chakkums/smart-solar/Report & Schematics/Pictures/2013-03-19 19.55.42.jpg

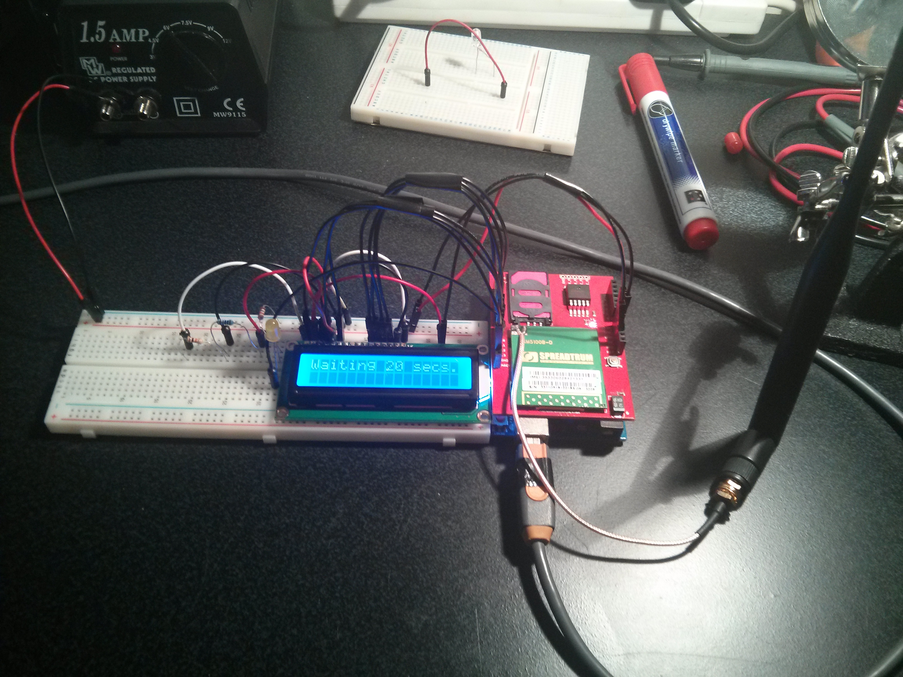
Report & Schematics/Pictures/2013-03-19 19.55.42.jpg
