chakkums/smart-solar/Report & Schematics/Pictures/2013-03-19 19.56.19.jpg

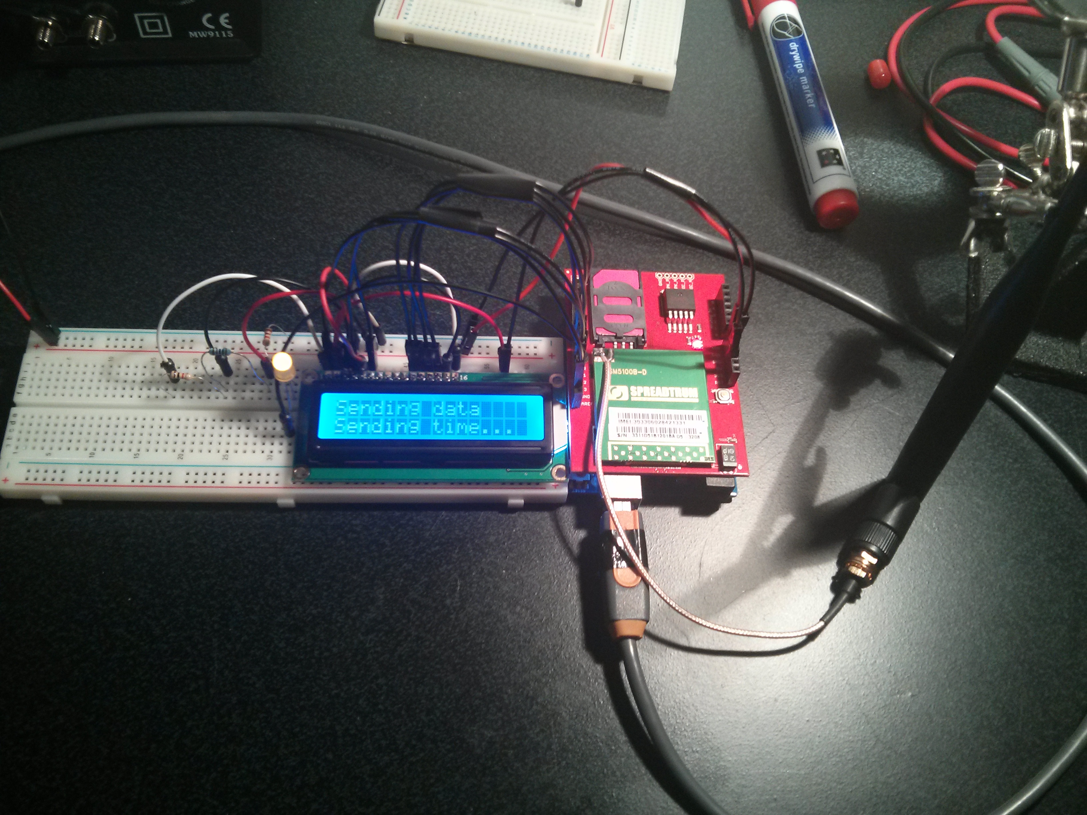
Report & Schematics/Pictures/2013-03-19 19.56.19.jpg
