chakkums/smart-solar/Report & Schematics/Pictures/2013-03-19 19.56.22.jpg

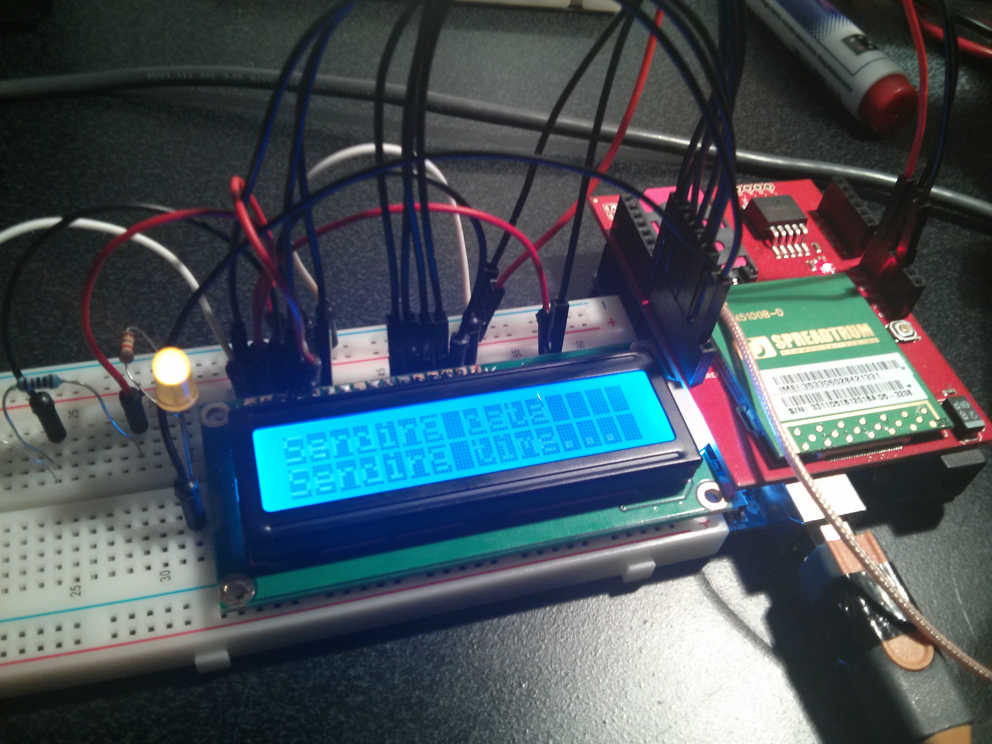
Report & Schematics/Pictures/2013-03-19 19.56.22.jpg
