chakkums/smart-solar/Report & Schematics/Pictures/2013-03-19 19.57.33.jpg

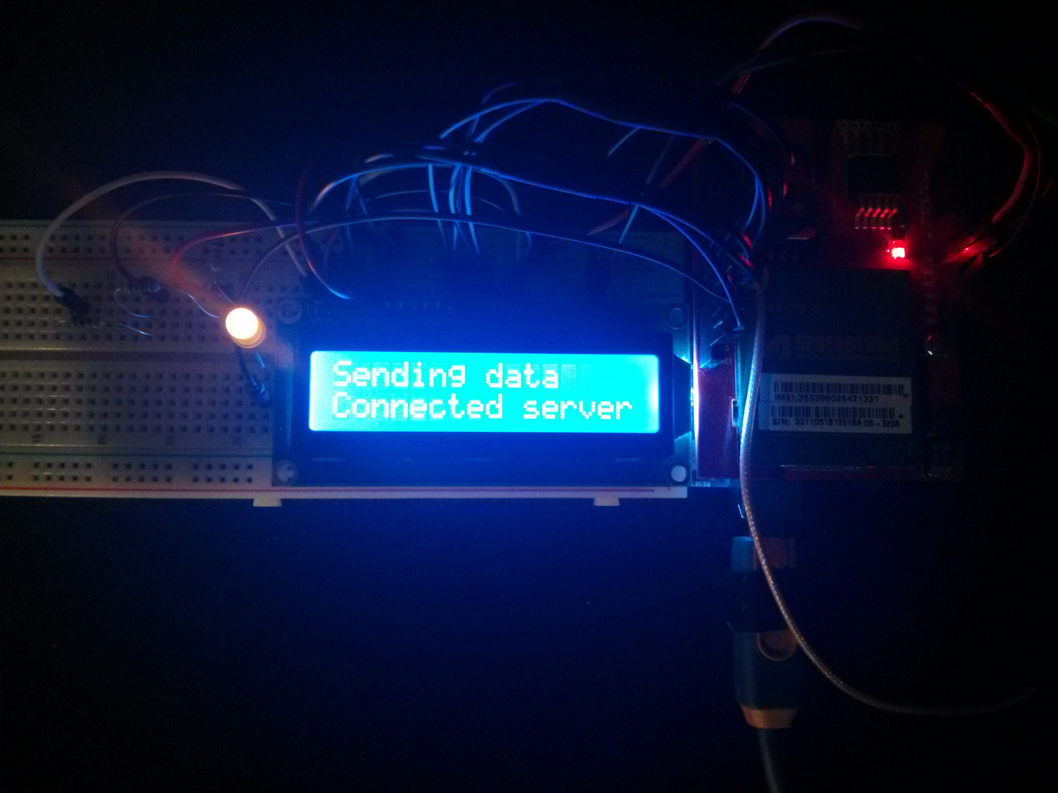
Report & Schematics/Pictures/2013-03-19 19.57.33.jpg
