chakkums/smart-solar/Report & Schematics/Pictures/2013-03-19 19.57.35.jpg

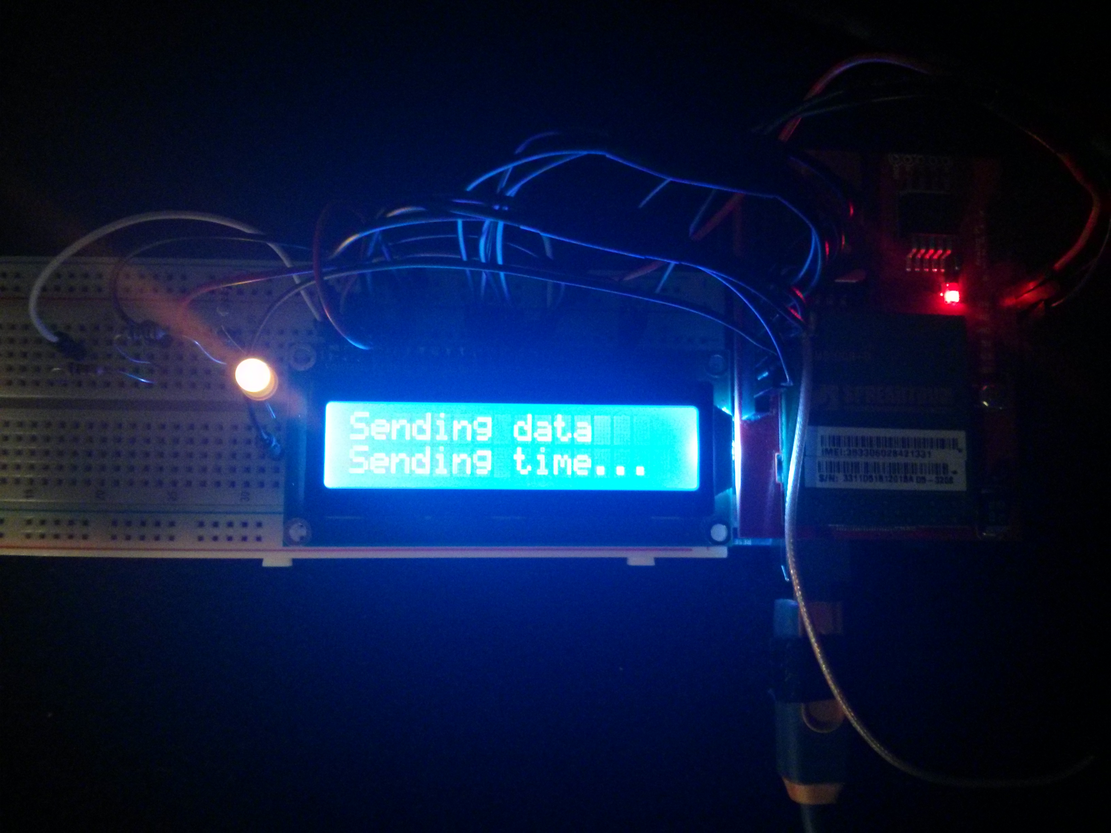
Report & Schematics/Pictures/2013-03-19 19.57.35.jpg
