chakkums/smart-solar/Report & Schematics/Pictures/2013-03-19 19.58.29.jpg

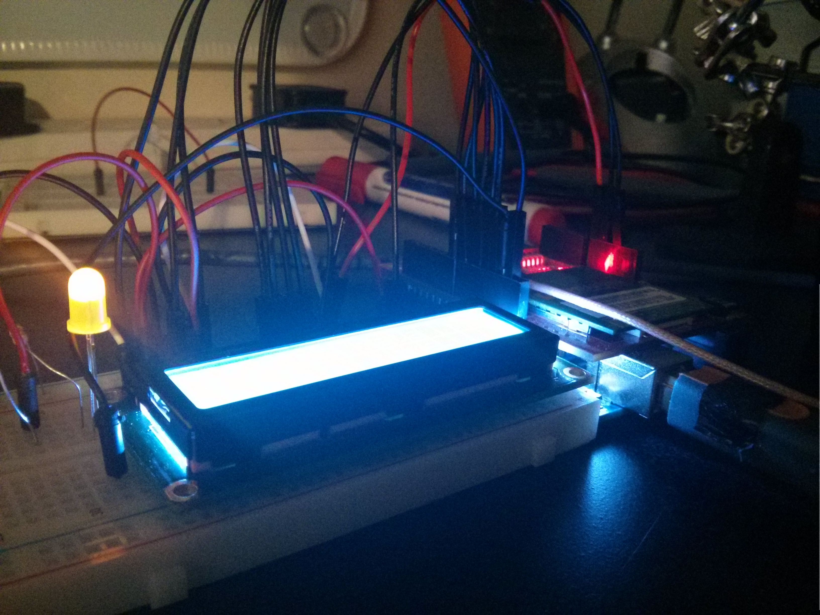
Report & Schematics/Pictures/2013-03-19 19.58.29.jpg
