chakkums/smart-solar/Report & Schematics/Pictures/2013-04-06 00.31.32.jpg

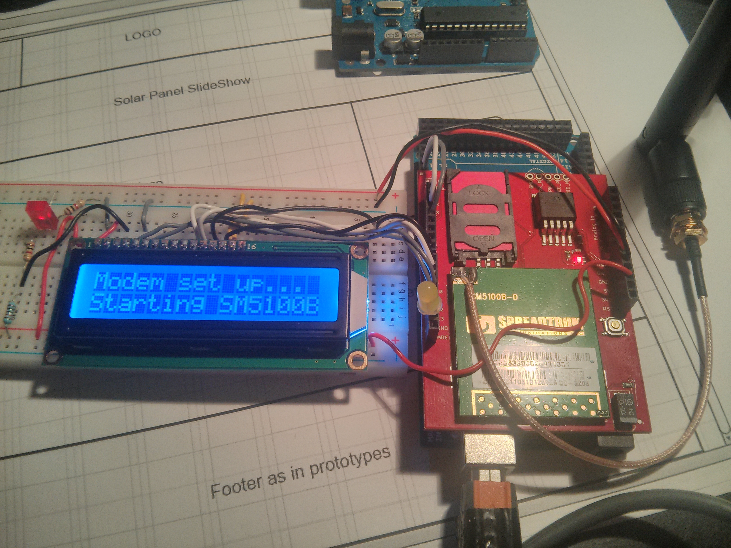
Report & Schematics/Pictures/2013-04-06 00.31.32.jpg
