chakkums/smart-solar/Report & Schematics/Pictures/2013-04-06 00.31.44.jpg

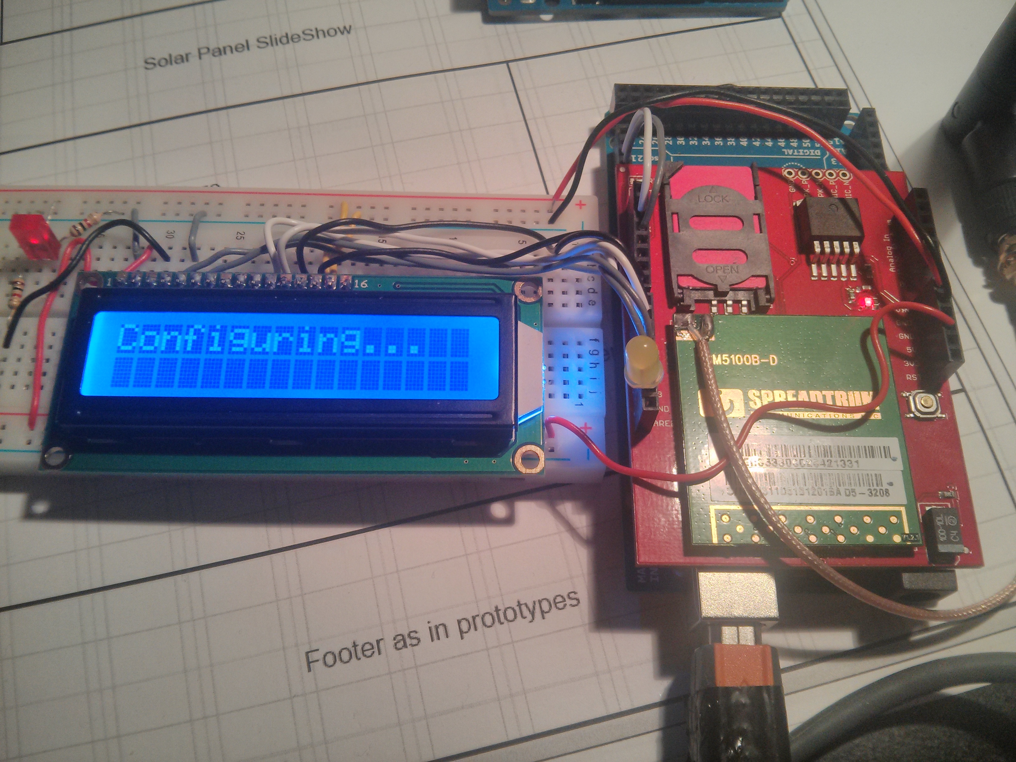
Report & Schematics/Pictures/2013-04-06 00.31.44.jpg
