chakkums/smart-solar/Report & Schematics/Pictures/2013-04-06 00.32.01.jpg

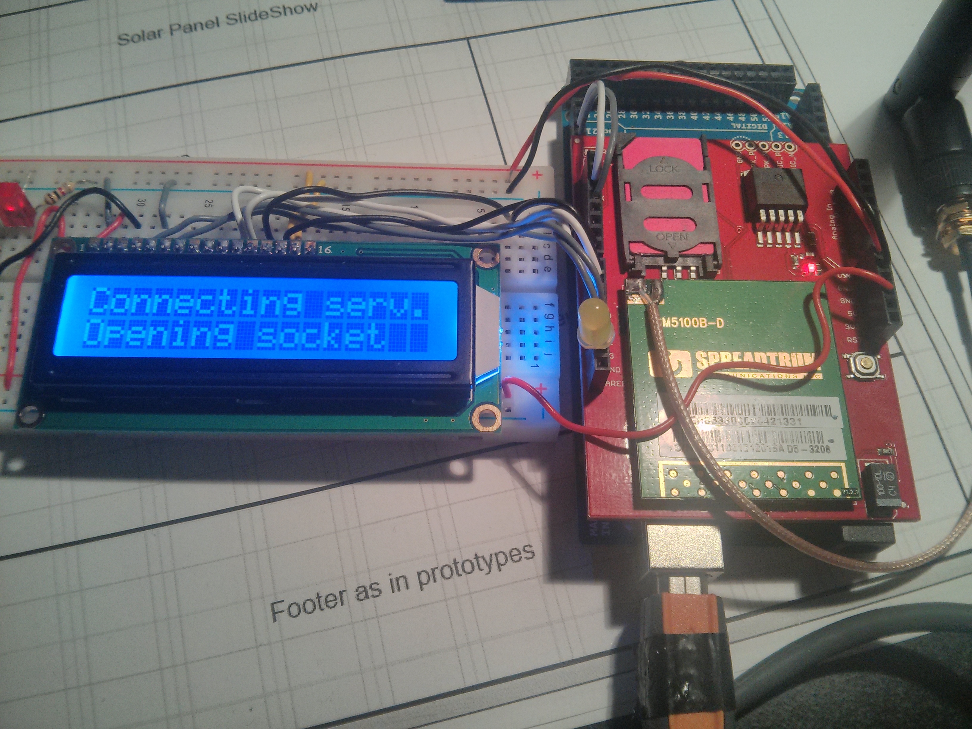
Report & Schematics/Pictures/2013-04-06 00.32.01.jpg
