chakkums/smart-solar/Report & Schematics/Pictures/2013-04-06 00.32.06.jpg

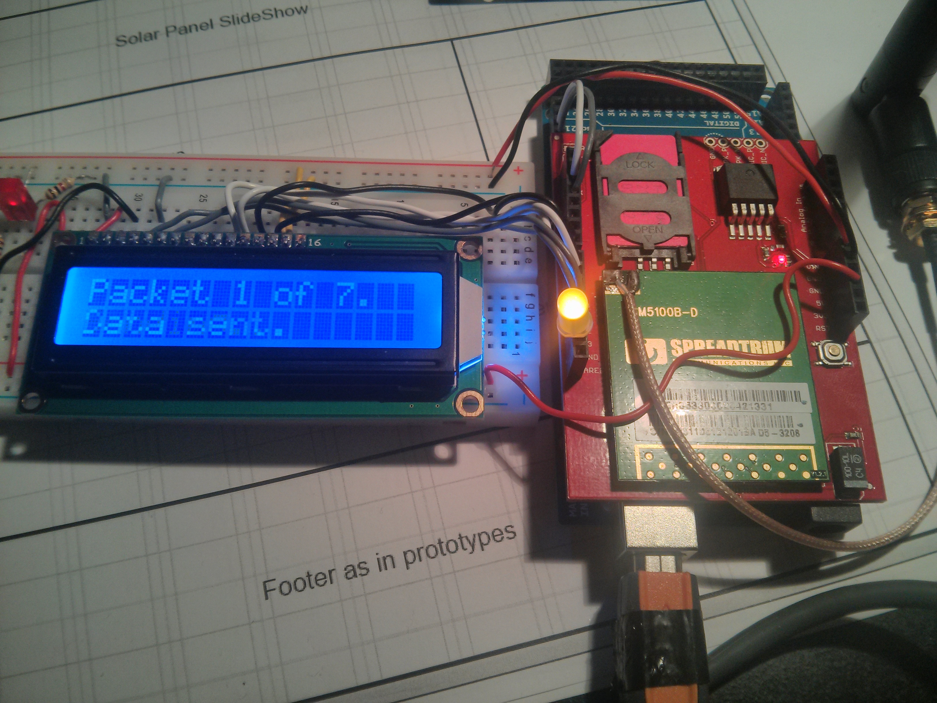
Report & Schematics/Pictures/2013-04-06 00.32.06.jpg
