chakkums/smart-solar/Report & Schematics/Pictures/2013-04-06 00.33.11.jpg

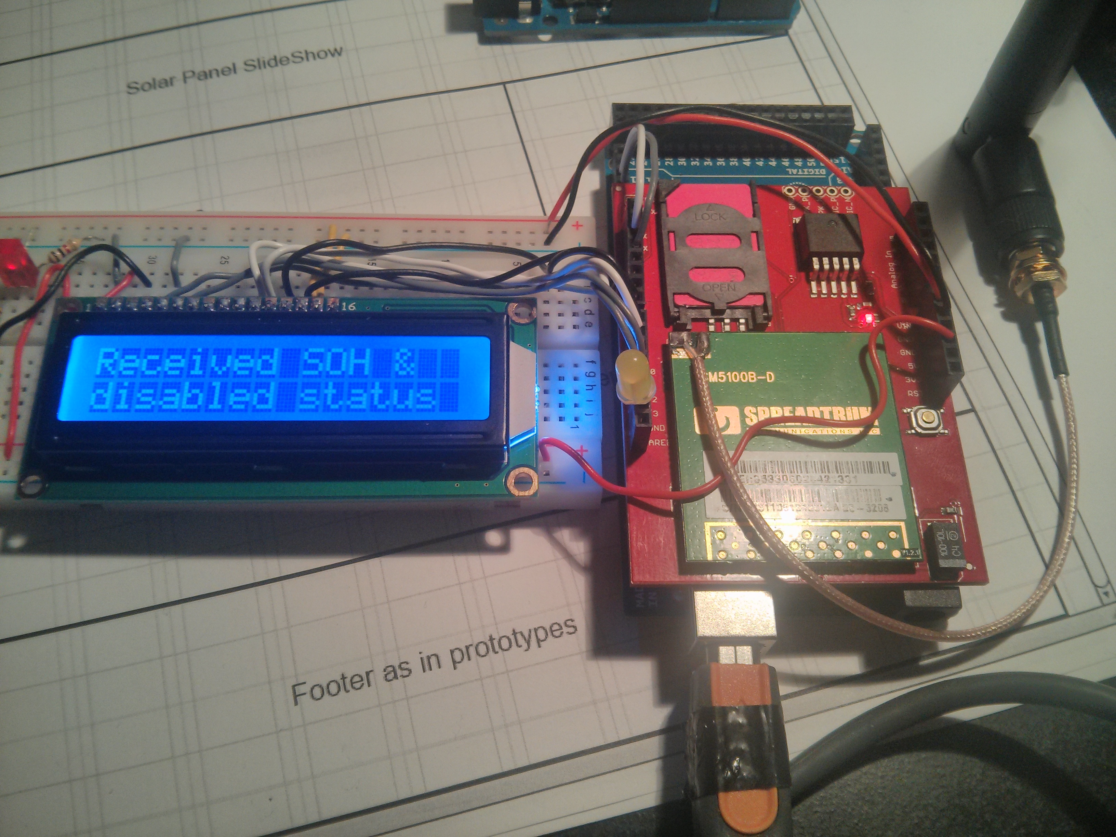
Report & Schematics/Pictures/2013-04-06 00.33.11.jpg
