chakkums/smart-solar/Report & Schematics/Pictures/2013-04-07 18.26.47.jpg

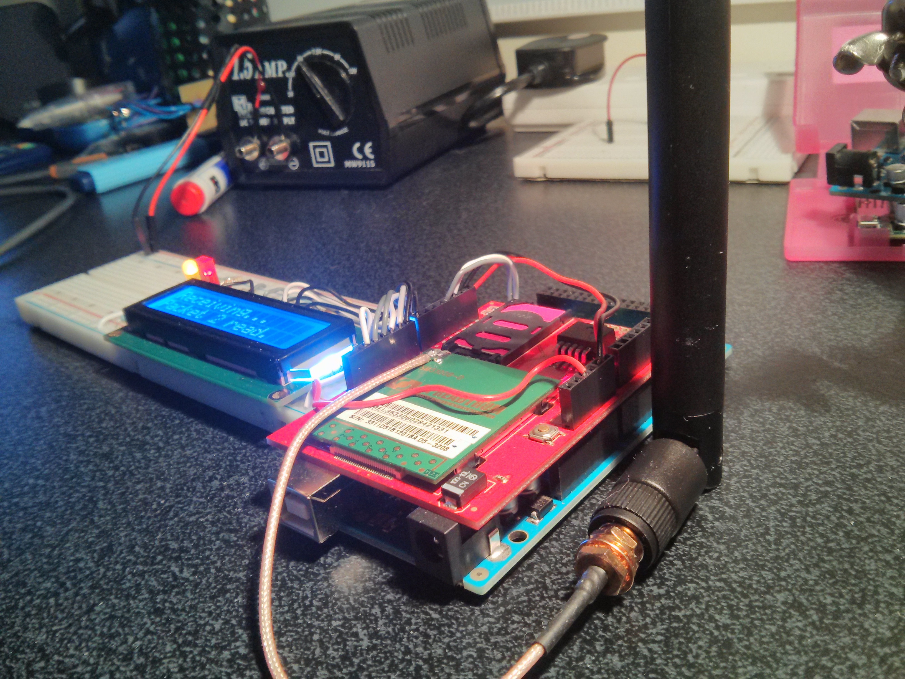
Report & Schematics/Pictures/2013-04-07 18.26.47.jpg
