chakkums/smart-solar/Report & Schematics/Pictures/2013-04-17 01.26.34.jpg

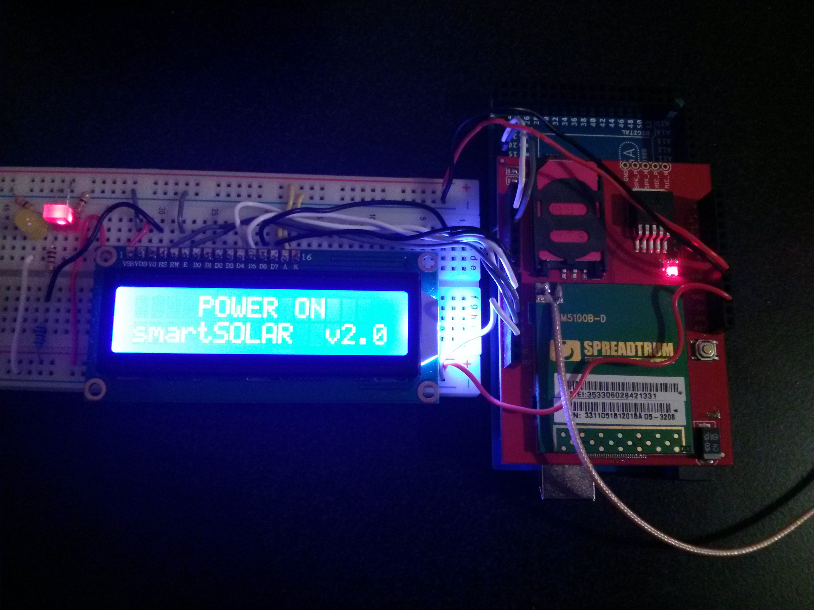
Report & Schematics/Pictures/2013-04-17 01.26.34.jpg
