chakkums/smart-solar/Report & Schematics/Schematics/Prototype Circuit_bb.png

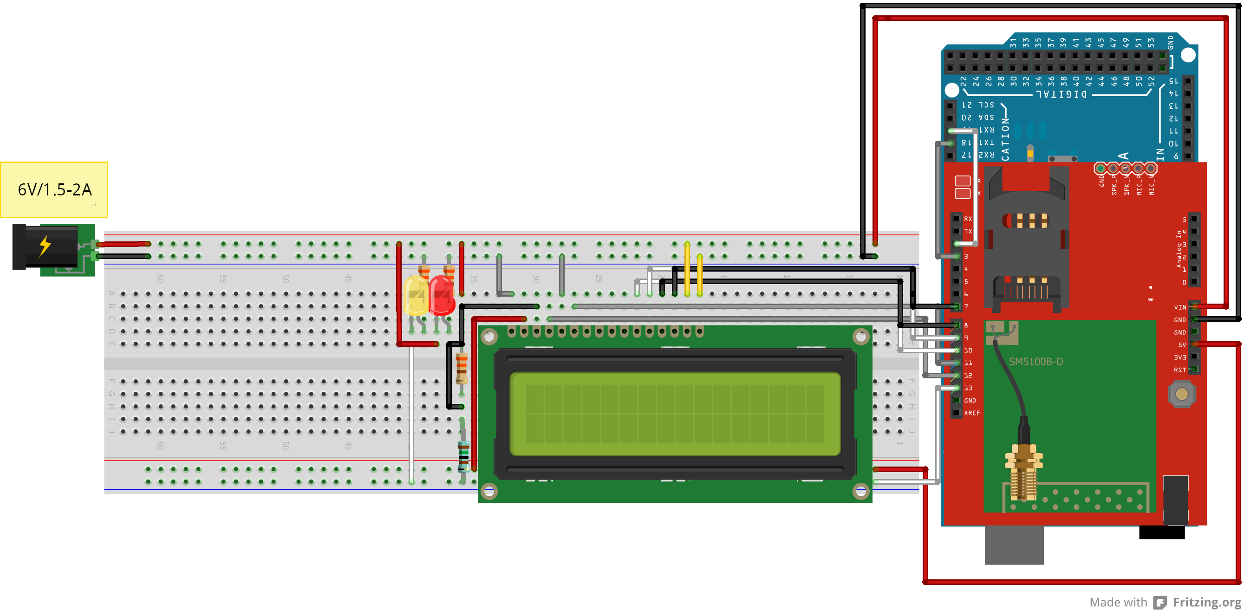
Report & Schematics/Schematics/Prototype Circuit_bb.png
