chakkums/smart-solar/Report & Schematics/Schematics/Prototype Circuit_schem.png

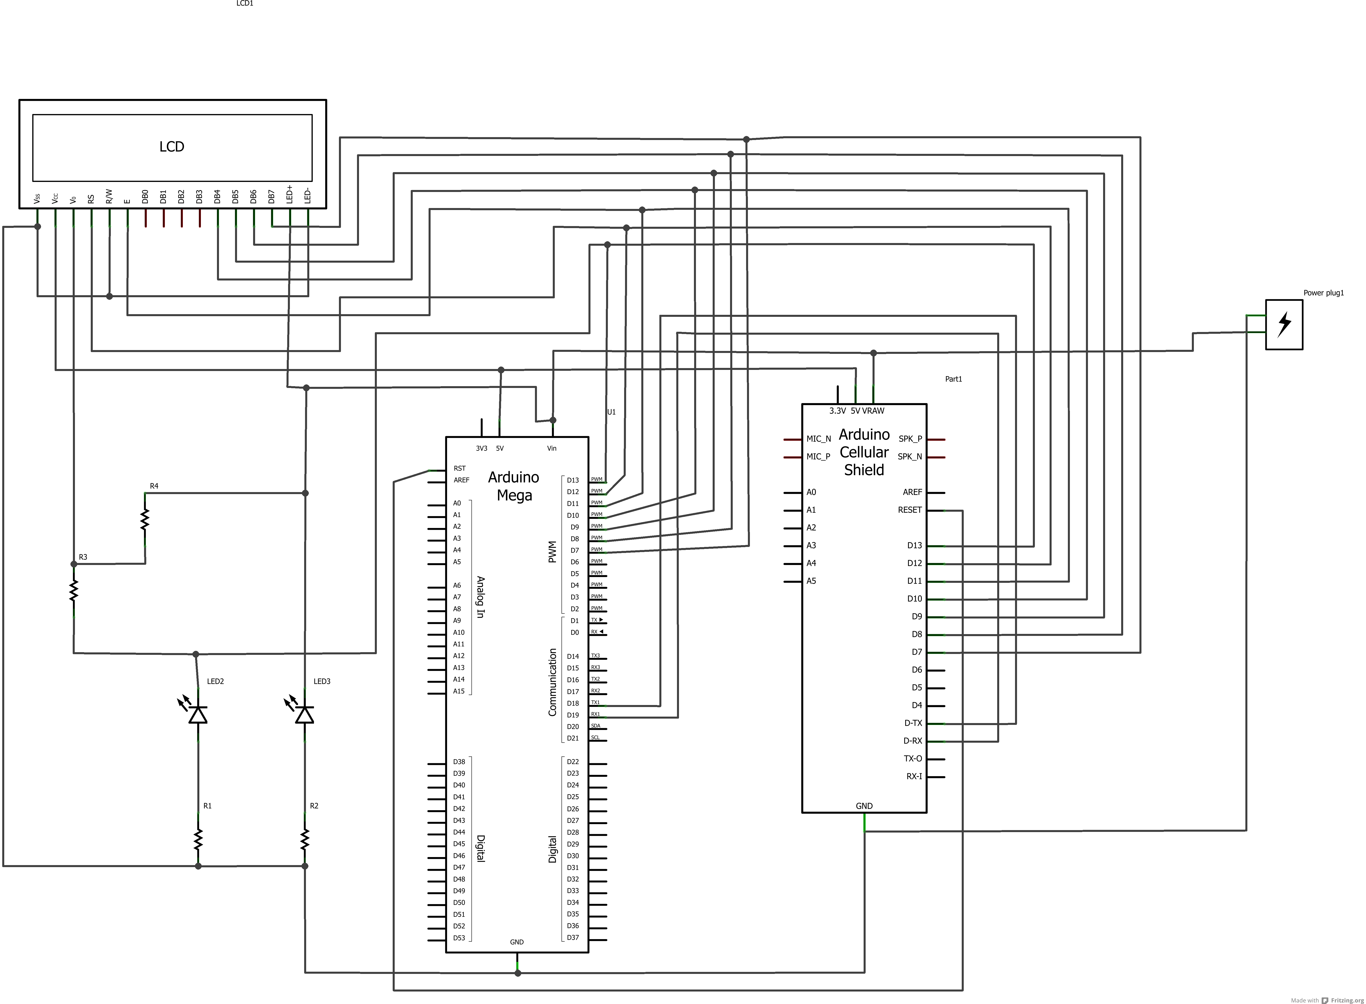
Report & Schematics/Schematics/Prototype Circuit_schem.png
