chakkums/smart-solar/Report & Schematics/Screenshots/Battery - smartSOLAR (1).png

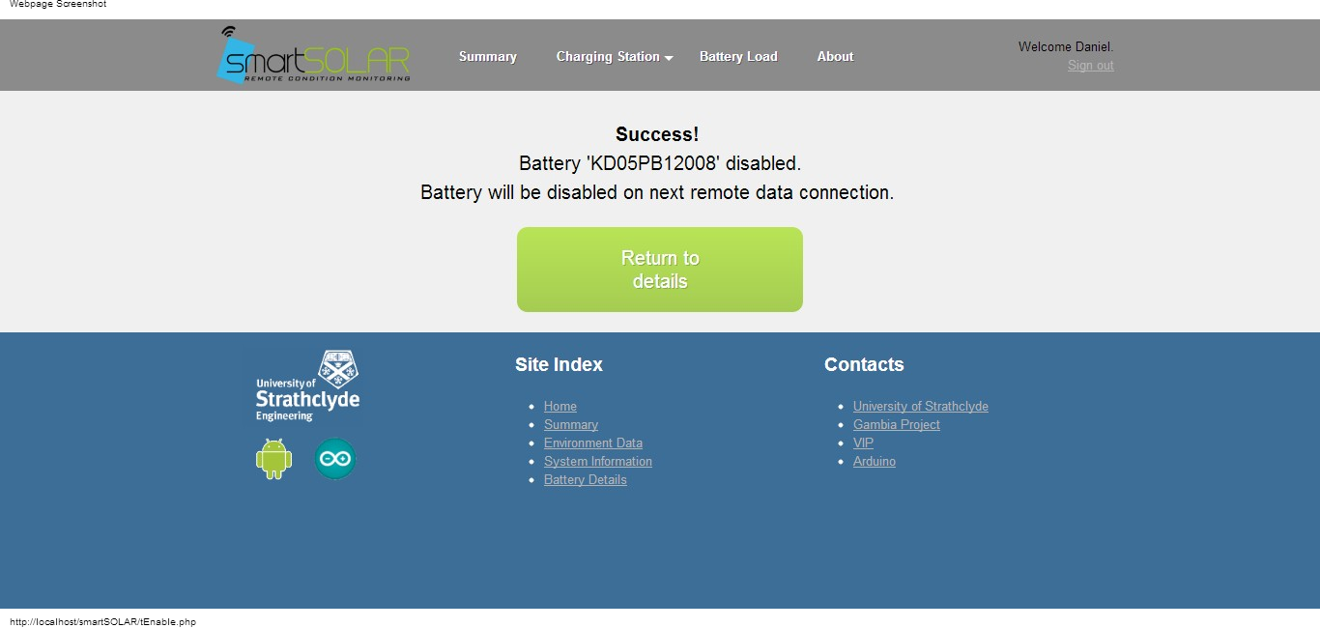
Report & Schematics/Screenshots/Battery - smartSOLAR (1).png
