chakkums/smart-solar/Report & Schematics/Screenshots/Electrical Loads - smartSOLAR (1).png

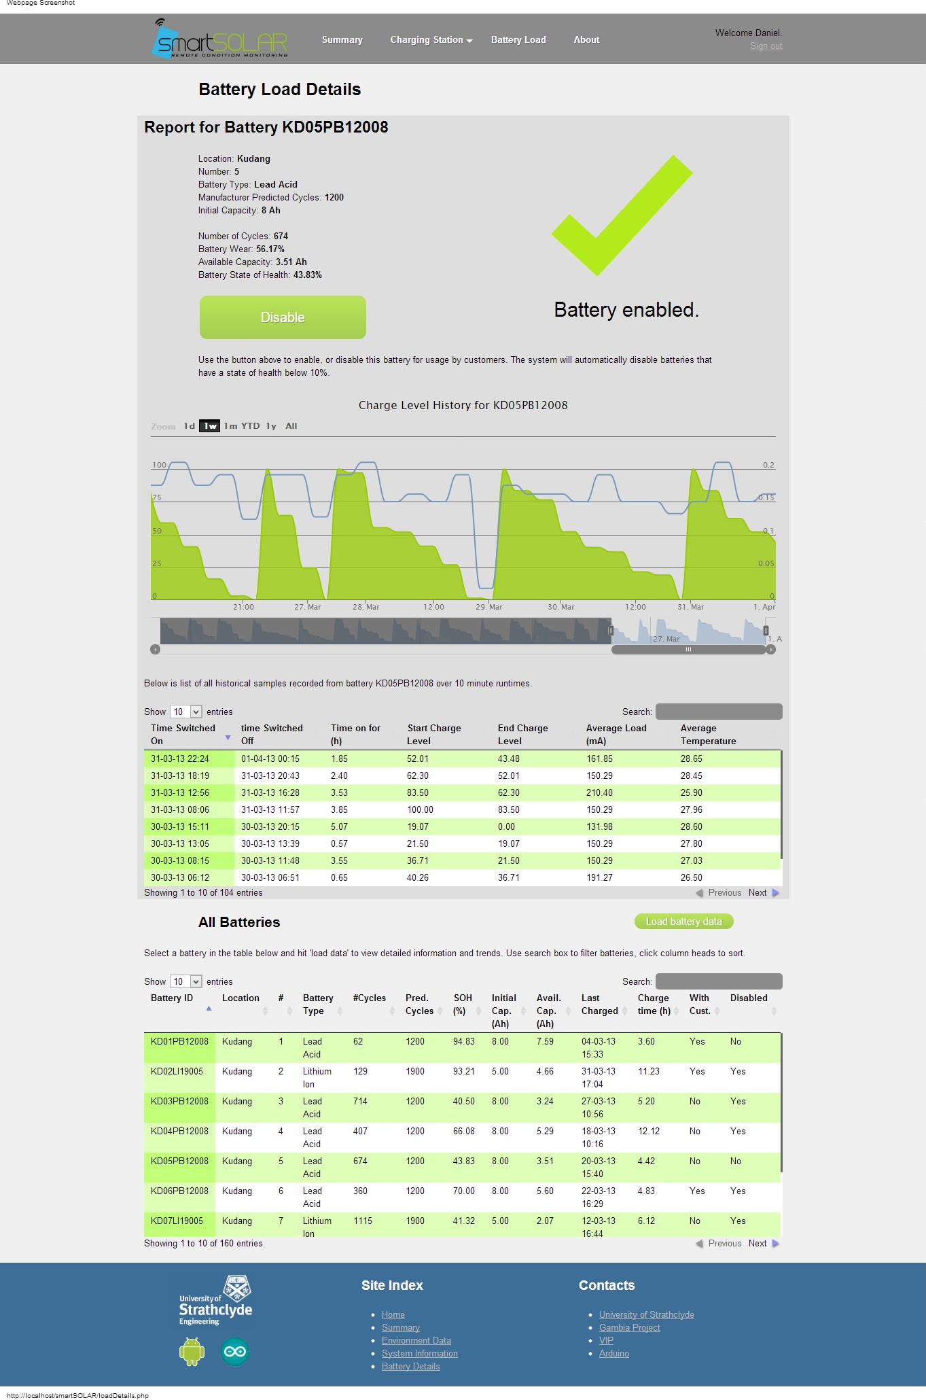
Report & Schematics/Screenshots/Electrical Loads - smartSOLAR (1).png
