chakkums/smart-solar/Report & Schematics/Screenshots/Environment - smartSOLAR (1).png

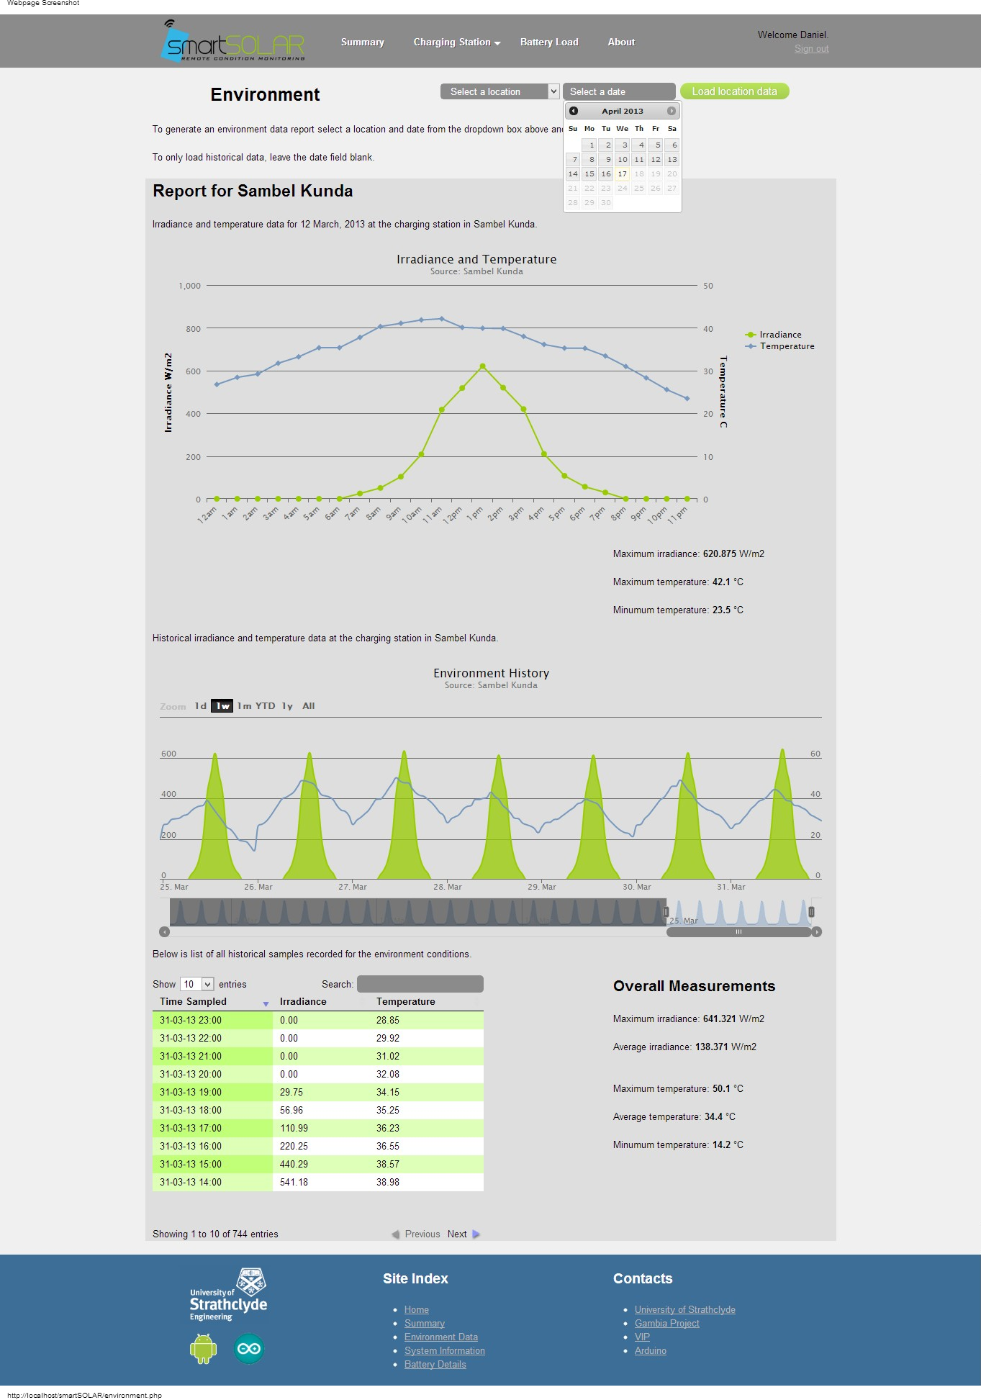
Report & Schematics/Screenshots/Environment - smartSOLAR (1).png
