chakkums/smart-solar/Report & Schematics/Screenshots/Login - smartSOLAR.png

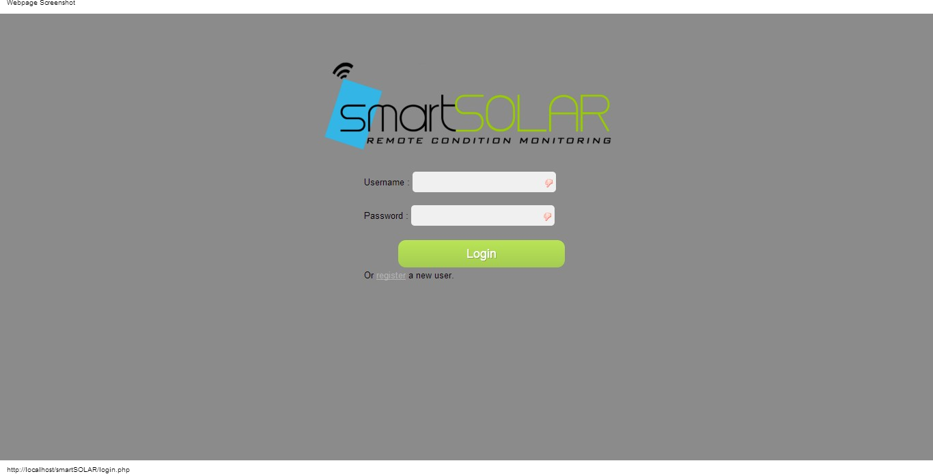
Report & Schematics/Screenshots/Login - smartSOLAR.png
