chakkums/smart-solar/Report & Schematics/Screenshots/Register - smartSOLAR.png

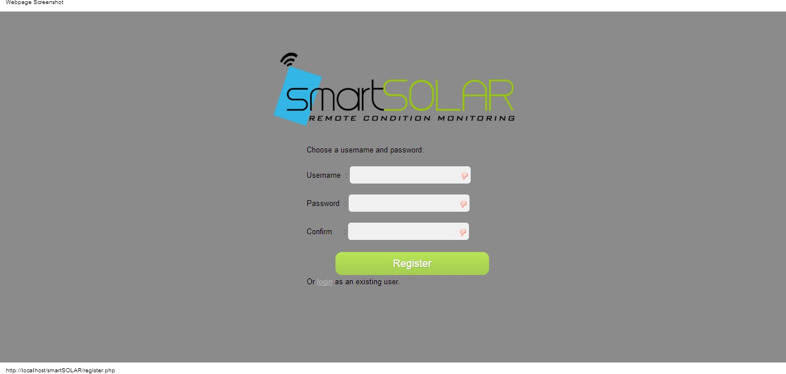
Report & Schematics/Screenshots/Register - smartSOLAR.png
