chakkums/smart-solar/Report & Schematics/Screenshots/smartSOLAR (2).png

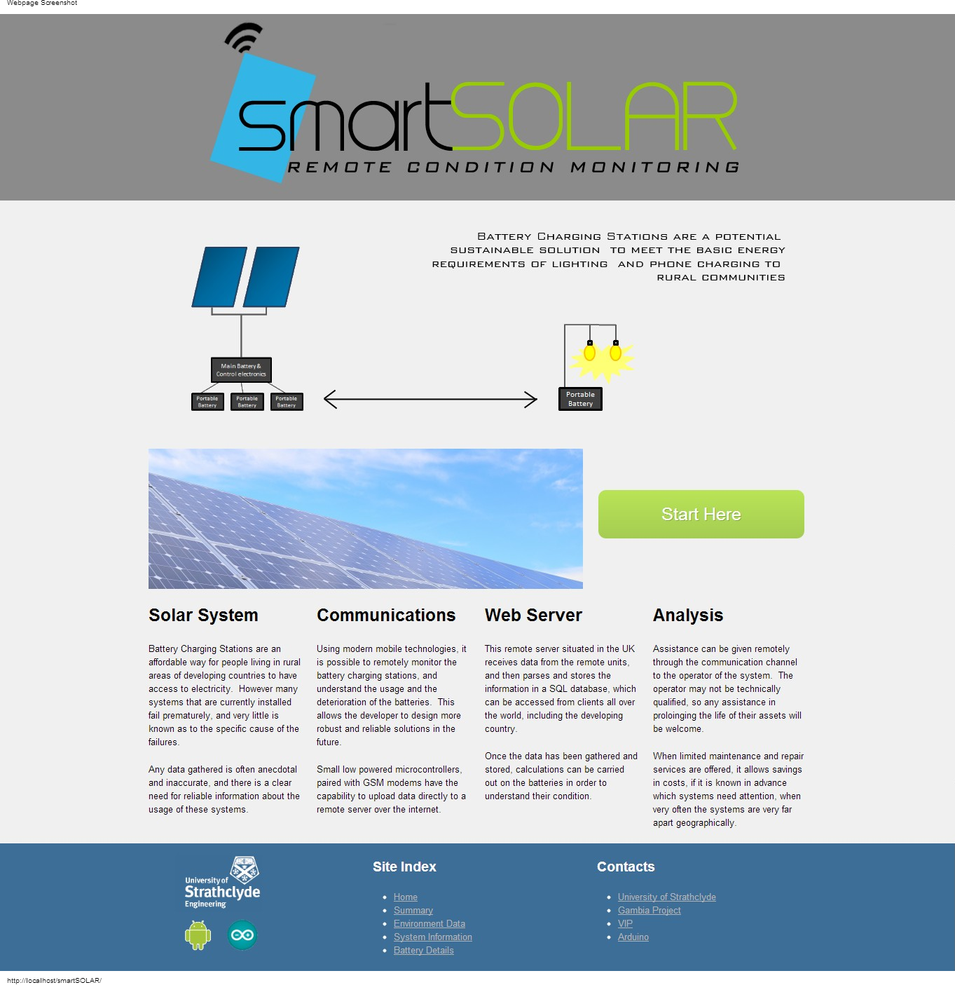
Report & Schematics/Screenshots/smartSOLAR (2).png
