chakkums/smart-solar/Report & Schematics/Screenshots/Summary - smartSOLAR (1).png

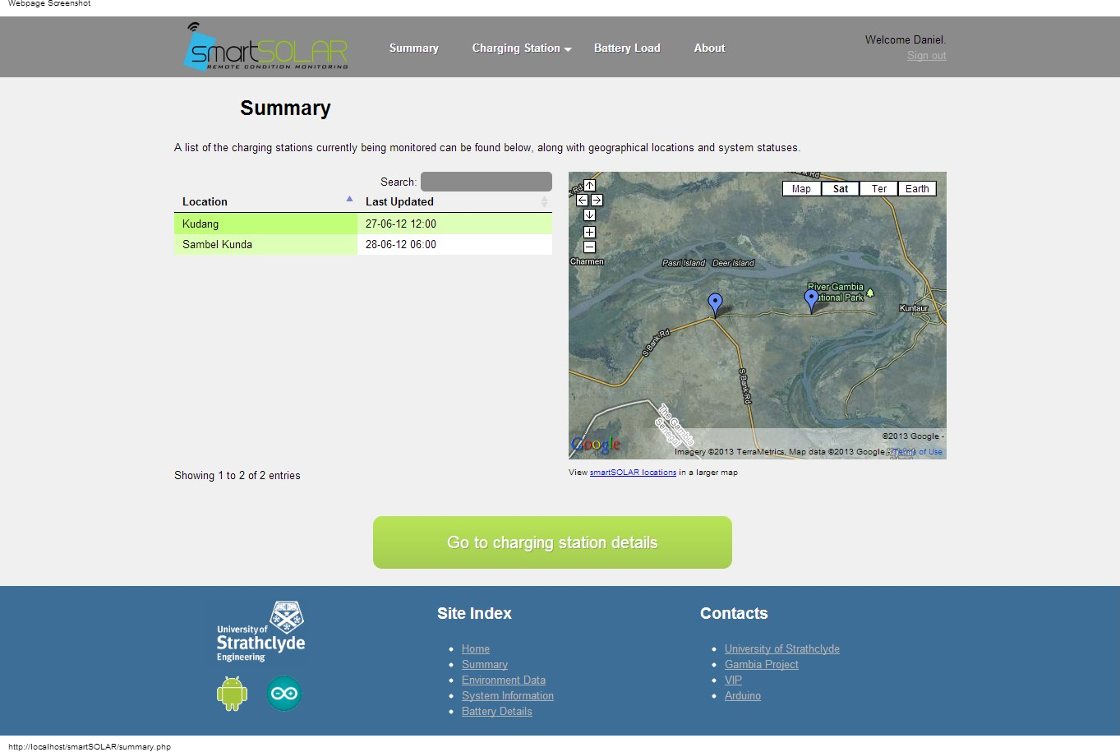
Report & Schematics/Screenshots/Summary - smartSOLAR (1).png
