chakkums/smart-solar/Report & Schematics/Screenshots/System Information - smartSOLAR (1).png

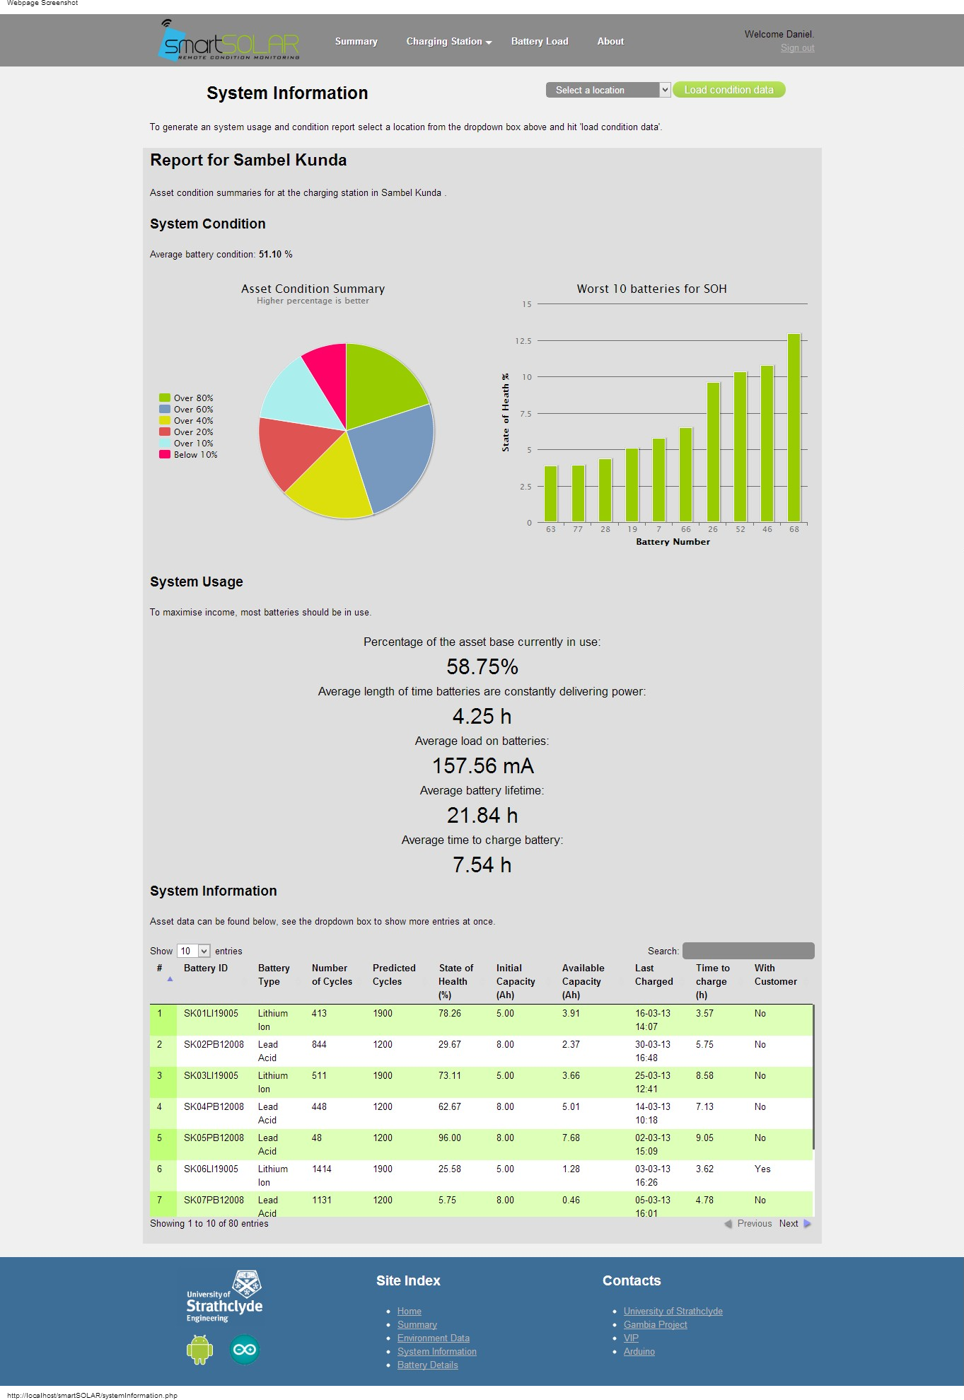
Report & Schematics/Screenshots/System Information - smartSOLAR (1).png
