chakkums/smart-solar/Web Application/v2.2 smartSOLAR/images/cross.png

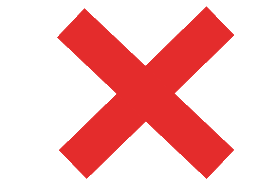
Web Application/v2.2 smartSOLAR/images/cross.png
