chakkums/smart-solar/Web Application/v2.2 smartSOLAR/images/howitworks.png

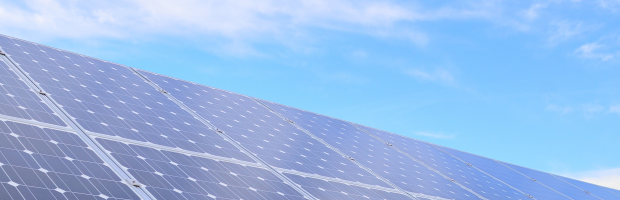
Web Application/v2.2 smartSOLAR/images/howitworks.png
