chakkums/smart-solar/Web Application/v2.2 smartSOLAR/images/login/smartSolarLogin.png

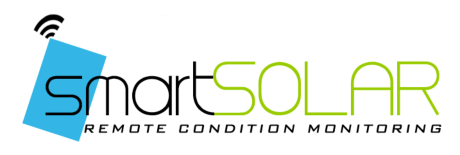
Web Application/v2.2 smartSOLAR/images/login/smartSolarLogin.png
