chakkums/smart-solar/Web Application/v2.2 smartSOLAR/images/slideshow/2.png

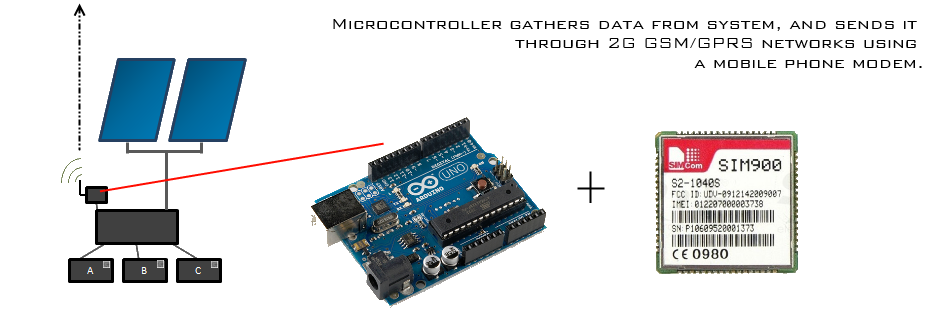
Web Application/v2.2 smartSOLAR/images/slideshow/2.png
