chakkums/smart-solar/Web Application/v2.2 smartSOLAR/images/slideshow/3.png

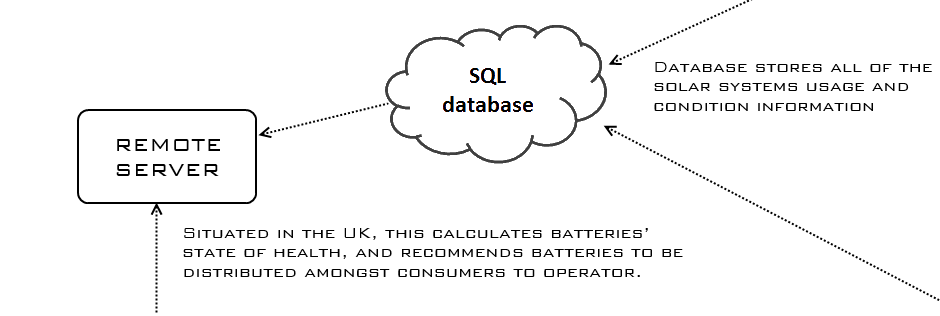
Web Application/v2.2 smartSOLAR/images/slideshow/3.png
