chakkums/smart-solar/Web Application/v2.2 smartSOLAR/images/smartSolarMain.png

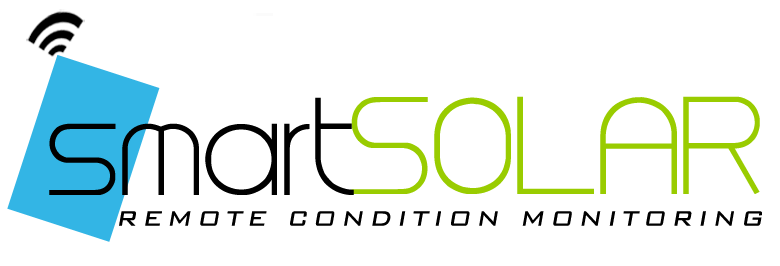
Web Application/v2.2 smartSOLAR/images/smartSolarMain.png
