chakkums/smart-solar/Web Application/v2.2 smartSOLAR/images/tick.png

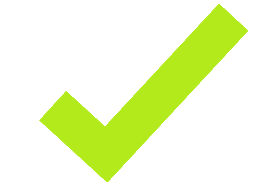
Web Application/v2.2 smartSOLAR/images/tick.png
