chakkums/smart-solar/Testing/QRcodes.docx

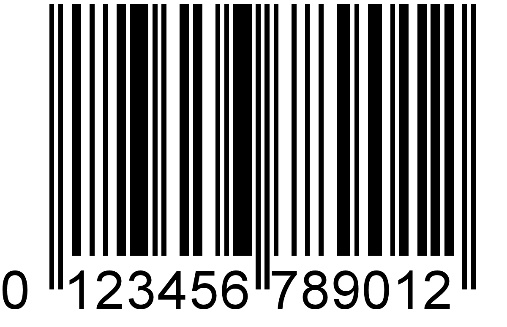
[picture p77: figure]
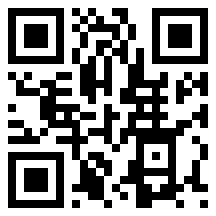
[picture p78: figure]
QRCode
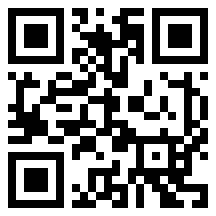
[picture p79: figure]
QRCode
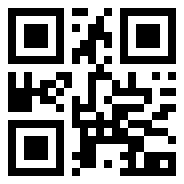
[picture p80: figure]
QRCode
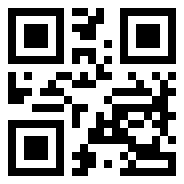
[picture p81: figure]
QRCode
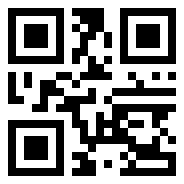
[picture p82: figure]
QRCode
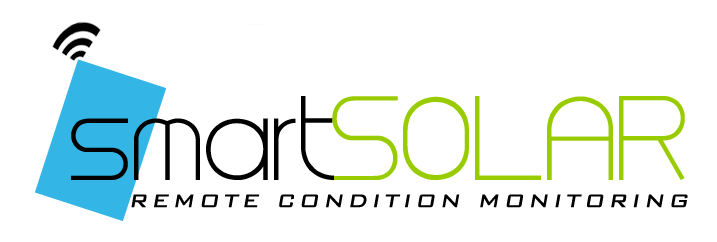
[picture p83: figure]

https://www.google.co.uk/

THIS IS NOT A BATTERY ID

SK72LI19005

KD77PB12008

SK04PB12008

SAMPLE QR CODES
