chakkums/smart-solar/Testing/Site Prototyping/chart_test.html

smartSOLAR

- Charging Station
- Portable Batteries
- Environment

LOGIN INFORMATION (logout)

Affiliate Logos

#### Site Index

- Stuff
- More Stuff

#### Contacts

- University of Strathclyde (http://www.strath.ac.uk)
- Gambia Project (http://www.strath.ac.uk/eee/gambiaproject/)
- Arduino (http://arduino.cc)
- 960.gs
