chakkums/smart-solar/Testing/Site Prototyping/index.html

smartSOLAR

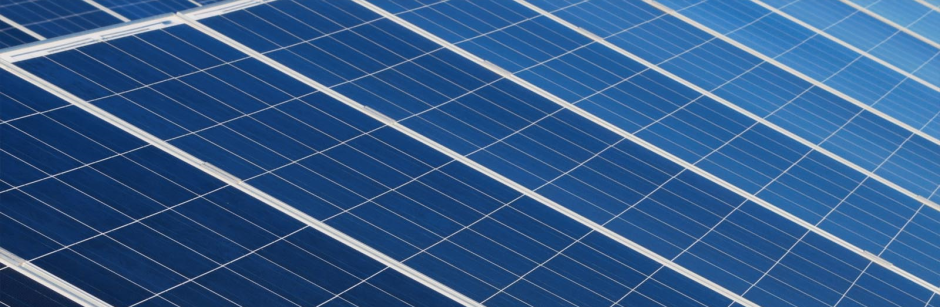
[picture p84: Testing/Site Prototyping/images/slideshow/1.png]
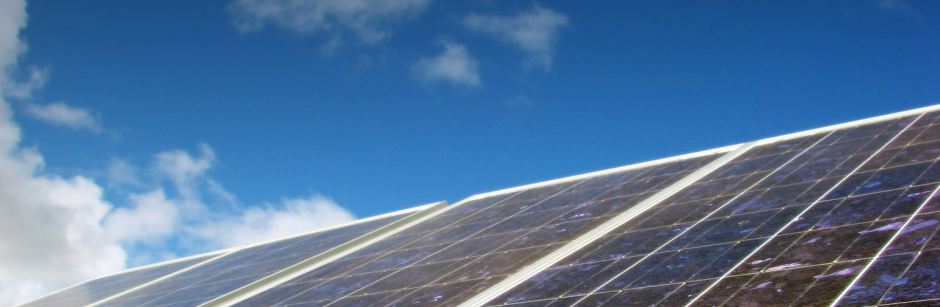
[picture p85: Testing/Site Prototyping/images/slideshow/3.png]
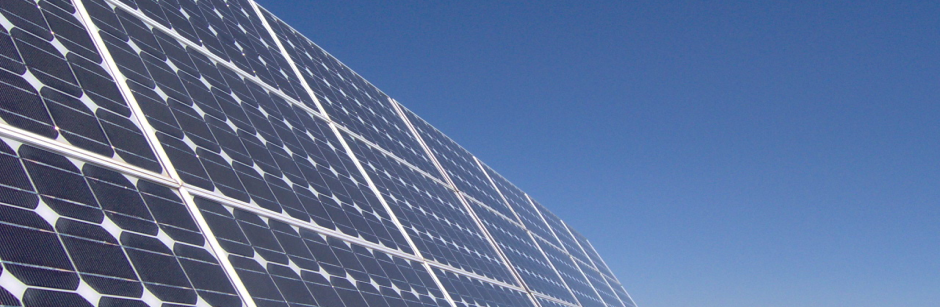
[picture p86: Testing/Site Prototyping/images/slideshow/2.png]
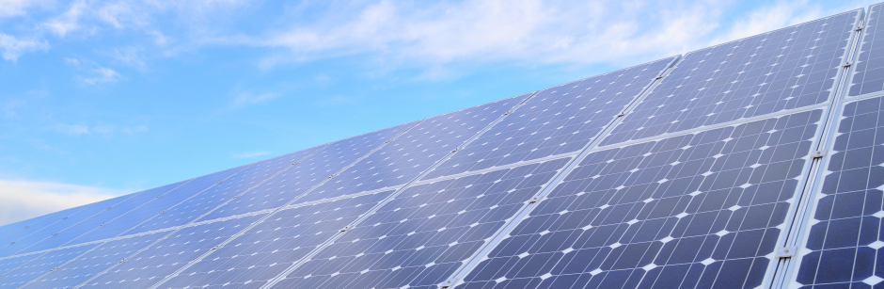
[picture p87: Testing/Site Prototyping/images/slideshow/4.png]
   

- Login
- How it works

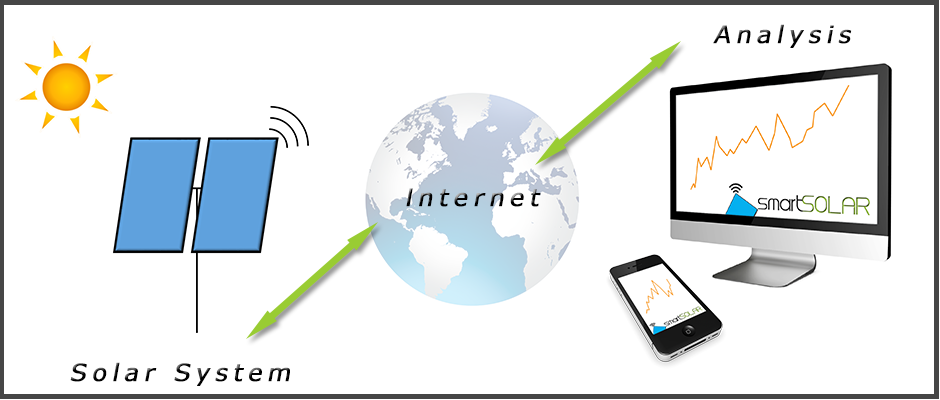
[picture p88: Testing/Site Prototyping/images/summaryDiagram.png]
System Overview


# Solar System

Lorem Ipsum is simply dummy text of the printing and typesetting industry. Lorem Ipsum has been the industry's standard dummy text ever since the 1500s, when an unknown printer took a galley of type and scrambled it to make a type specimen book.

# Communications

Lorem Ipsum is simply dummy text of the printing and typesetting industry. Lorem Ipsum has been the industry's standard dummy text ever since the 1500s, when an unknown printer took a galley of type and scrambled it to make a type specimen book.

# Web Server

Lorem Ipsum is simply dummy text of the printing and typesetting industry. Lorem Ipsum has been the industry's standard dummy text ever since the 1500s, when an unknown printer took a galley of type and scrambled it to make a type specimen book.

# Analysis

Lorem Ipsum is simply dummy text of the printing and typesetting industry. Lorem Ipsum has been the industry's standard dummy text ever since the 1500s, when an unknown printer took a galley of type and scrambled it to make a type specimen book.

Affiliate Logos

#### Site Index

- Stuff
- More Stuff

#### Contacts

- University of Strathclyde (http://www.strath.ac.uk)
- Gambia Project (http://www.strath.ac.uk/eee/gambiaproject/)
- Arduino (http://arduino.cc)
- 960.gs
