chakkums/smart-solar/Testing/Site Prototyping/summary.html

smartSOLAR

- System Summary
- Charging Station
- Portable Batteries
- Environment

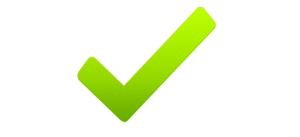
[picture p89: Testing/Site Prototyping/images/tick.png]
OK


#### System Status

- Last Updated: XX
- Total batteries: XX

#### Useful Links

- Analysis
- Configuration

### Environment

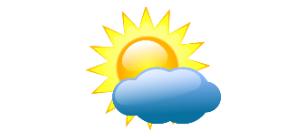
[picture p90: Testing/Site Prototyping/images/weather.png]
Sun


#### Current Readings

- Time
- Irradiance
- Wind Speed
- Temperature

### Charging Station

#### Current Readings

- Time
- Irradiance
- Wind Speed
- Temperature

Affiliate Logos

#### Site Index

- Stuff
- More Stuff

#### Contacts

- University of Strathclyde (http://www.strath.ac.uk)
- Gambia Project (http://www.strath.ac.uk/eee/gambiaproject/)
- Arduino (http://arduino.cc)
- 960.gs
