chakkums/smart-solar/Testing/Site Prototyping/smartsolar.html

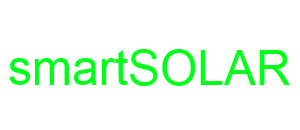
[picture p91: Testing/Site Prototyping/images/introLogo.png]
smartSOLAR


Login UserName*: Password*:
