chakkums/smart-solar/Testing/Site Prototyping/_vti_cnf/chart_test.html

vti_encoding:SR|utf8-nl vti_author:SR|DSEVEN\\Daniel vti_modifiedby:SR|DLAPTOP\\Daniel vti_timelastmodified:TR|23 Feb 2013 22:11:06 -0000 vti_timecreated:TR|21 Feb 2013 17:42:22 -0000 vti_title:SR|Chart Test vti_extenderversion:SR|12.0.0.0 vti_backlinkinfo:VX| vti_nexttolasttimemodified:TW|21 Feb 2013 22:15:29 -0000 vti_cacheddtm:TX|23 Feb 2013 22:11:06 -0000 vti_filesize:IR|10676 vti_cachedtitle:SR|Chart Test vti_cachedbodystyle:SR| vti_cachedlinkinfo:VX|Q|css/default.css Q|css/960/960.css Q|css/960/reset.css Q|css/960/text.css Q|css/chart_test.css S|http://ajax.googleapis.com/ajax/libs/jquery/1.8.2/jquery.min.js S|http://code.highcharts.com/highcharts.js S|http://code.highcharts.com/modules/exporting.js S|/js/themes/gray.js S|images/placeholderLogo.png S|images/logos.png H|http://www.strath.ac.uk H|http://www.strath.ac.uk/eee/gambiaproject/ H|http://arduino.cc H|http://960.gs vti_cachedsvcrellinks:VX|FQUS|css/default.css FQUS|css/960/960.css FQUS|css/960/reset.css FQUS|css/960/text.css FQUS|css/chart_test.css NSHS|http://ajax.googleapis.com/ajax/libs/jquery/1.8.2/jquery.min.js NSHS|http://code.highcharts.com/highcharts.js NSHS|http://code.highcharts.com/modules/exporting.js NSUS|/js/themes/gray.js FSUS|images/placeholderLogo.png FSUS|images/logos.png NHHS|http://www.strath.ac.uk NHHS|http://www.strath.ac.uk/eee/gambiaproject/ NHHS|http://arduino.cc NHHS|http://960.gs vti_cachedneedsrewrite:BR|false vti_cachedhasbots:BR|false vti_cachedhastheme:BR|false vti_cachedhasborder:BR|false vti_metatags:VR|HTTP-EQUIV=Content-Type text/html;\\ charset=utf-8 vti_charset:SR|utf-8
