chakkums/smart-solar/Testing/Site Prototyping/_vti_cnf/index.html

vti_encoding:SR|utf8-nl vti_timelastmodified:TR|13 Nov 2012 01:24:50 -0000 vti_extenderversion:SR|12.0.0.0 vti_author:SR|DLAPTOP\\Daniel vti_modifiedby:SR|DSEVEN\\Daniel vti_timecreated:TR|10 Nov 2012 22:14:01 -0000 vti_title:SR|smartSOLAR-Home vti_backlinkinfo:VX| vti_nexttolasttimemodified:TW|13 Nov 2012 01:23:54 -0000 vti_cacheddtm:TX|13 Nov 2012 01:24:50 -0000 vti_filesize:IR|3986 vti_cachedtitle:SR|smartSOLAR-Home vti_cachedbodystyle:SR| vti_cachedlinkinfo:VX|Q|css/default.css Q|css/960/960.css Q|css/960/reset.css Q|css/960/text.css S|\\ https://ajax.googleapis.com/ajax/libs/jquery/1.6.2/jquery.min.js S|js/jquery.cycle.all.js S|images/header.png S|images/slideshow/1.png S|images/slideshow/3.png S|images/slideshow/2.png S|images/slideshow/4.png H|summary.html S|images/summaryDiagram.png S|images/logos.png H|http://www.strath.ac.uk H|http://www.strath.ac.uk/eee/gambiaproject/ H|http://arduino.cc H|http://960.gs vti_cachedsvcrellinks:VX|FQUS|css/default.css FQUS|css/960/960.css FQUS|css/960/reset.css FQUS|css/960/text.css NSUS|\\ https://ajax.googleapis.com/ajax/libs/jquery/1.6.2/jquery.min.js FSUS|js/jquery.cycle.all.js FSUS|images/header.png FSUS|images/slideshow/1.png FSUS|images/slideshow/3.png FSUS|images/slideshow/2.png FSUS|images/slideshow/4.png FHUS|summary.html FSUS|images/summaryDiagram.png FSUS|images/logos.png NHHS|http://www.strath.ac.uk NHHS|http://www.strath.ac.uk/eee/gambiaproject/ NHHS|http://arduino.cc NHHS|http://960.gs vti_cachedneedsrewrite:BR|false vti_cachedhasbots:BR|false vti_cachedhastheme:BR|false vti_cachedhasborder:BR|false vti_metatags:VR|HTTP-EQUIV=Content-Type text/html;\\ charset=utf-8 vti_charset:SR|utf-8
