chakkums/smart-solar/Testing/Site Prototyping/_vti_cnf/smartsolar.html

vti_encoding:SR|utf8-nl vti_author:SR|DLAPTOP\\Daniel vti_modifiedby:SR|DLAPTOP\\Daniel vti_timelastmodified:TR|23 Feb 2013 22:40:32 -0000 vti_timecreated:TR|23 Feb 2013 22:10:08 -0000 vti_title:SR|smartSOLAR vti_extenderversion:SR|12.0.0.0 vti_backlinkinfo:VX| vti_nexttolasttimemodified:TW|23 Feb 2013 22:37:36 -0000 vti_cacheddtm:TX|23 Feb 2013 22:40:32 -0000 vti_filesize:IR|1265 vti_cachedtitle:SR|smartSOLAR vti_cachedbodystyle:SR| vti_cachedlinkinfo:VX|Q|css/default.css Q|css/960/960.css Q|css/960/reset.css Q|css/960/text.css Q|css/smartSOLAR.css S|images/introLogo.png A|login.php vti_cachedsvcrellinks:VX|FQUS|css/default.css FQUS|css/960/960.css FQUS|css/960/reset.css FQUS|css/960/text.css FQUS|css/smartSOLAR.css FSUS|images/introLogo.png NAUS|login.php vti_cachedneedsrewrite:BR|false vti_cachedhasbots:BR|false vti_cachedhastheme:BR|false vti_cachedhasborder:BR|false vti_metatags:VR|HTTP-EQUIV=Content-Type text/html;\\ charset=utf-8 vti_charset:SR|utf-8
