chakkums/smart-solar/Testing/Site Prototyping/_vti_cnf/summary.html

vti_encoding:SR|utf8-nl vti_timelastmodified:TR|21 Feb 2013 19:11:42 -0000 vti_extenderversion:SR|12.0.0.0 vti_author:SR|DLAPTOP\\Daniel vti_modifiedby:SR|DSEVEN\\Daniel vti_timecreated:TR|11 Nov 2012 12:59:25 -0000 vti_title:SR|smartSOLAR-System Summary vti_backlinkinfo:VX|index.html vti_nexttolasttimemodified:TW|21 Feb 2013 17:55:35 -0000 vti_cacheddtm:TX|21 Feb 2013 17:55:35 -0000 vti_filesize:IR|7380 vti_cachedtitle:SR|smartSOLAR-System Summary vti_cachedbodystyle:SR| vti_cachedlinkinfo:VX|Q|css/default.css Q|css/systemSummary.css Q|css/960/960.css Q|css/960/reset.css Q|css/960/text.css S|https://www.google.com/jsapi S|images/header.png S|images/tick.png S|images/weather.png S|images/logos.png H|http://www.strath.ac.uk H|http://www.strath.ac.uk/eee/gambiaproject/ H|http://arduino.cc H|http://960.gs vti_cachedsvcrellinks:VX|FQUS|css/default.css FQUS|css/systemSummary.css FQUS|css/960/960.css FQUS|css/960/reset.css FQUS|css/960/text.css NSSS|https://www.google.com/jsapi FSUS|images/header.png FSUS|images/tick.png FSUS|images/weather.png FSUS|images/logos.png NHHS|http://www.strath.ac.uk NHHS|http://www.strath.ac.uk/eee/gambiaproject/ NHHS|http://arduino.cc NHHS|http://960.gs vti_cachedneedsrewrite:BR|false vti_cachedhasbots:BR|false vti_cachedhastheme:BR|false vti_cachedhasborder:BR|false vti_metatags:VR|HTTP-EQUIV=Content-Type text/html;\\ charset=utf-8 vti_charset:SR|utf-8
