chakkums/smart-solar/Testing/Site Prototyping/images/panels.png

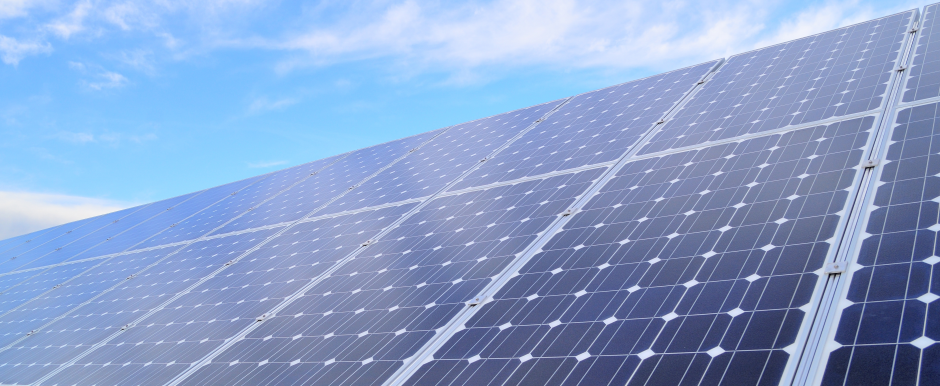
Testing/Site Prototyping/images/panels.png
