chakkums/smart-solar/(list of files, drawings)

Other design files:
Report & Schematics/Schematics/Prototype Circuit.fzz
