chakkums/smart-solar/Arduino/MegaModemControl_v2_0/MegaModemControl_v2_0.ino

#include <LiquidCrystal.h>
#include <Flash.h>

//IP address and port of the remote server
String IPaddress = "176.250.20.57";
String port = "6100";

LiquidCrystal lcd(12, 11, 10, 9, 8, 7);

String receivedString = "";

FLASH_STRING(fullString, 
                  "[SK310413:80[0003:258,0002:263,0000:283,0005:307,0003:322,0004:346,0003:349,0252:361,0511:375,1032:391,"
                  "2091:391,4193:396,5207:374,6225:350,5214:328,4211:321,2133:308,1079:305,0558:289,0288:284,0003:281,0003"
                  ":252,0004:229,0005:203][SK01LI19005:04:0413:0204132154:142:0[(0105130000:456:079:033:281)(0105130845:40"
                  "4:033:002:263)(0105131702:010:002:001:263)(0105131857:069:001:000:278)]][SK02PB12008:04:0844:0204131650"
                  ":504:1[(0105130000:329:081:056:288)(0105130703:472:056:016:282)(0105131620:439:016:000:265)(0205131035:"
                  "016:100:099:264)]][SK03LI19005:04:0511:0104132255:238:0[(0105130000:345:067:042:270)(0105130710:392:042"
                  ":012:283)(0105131515:221:012:000:264)(0205130532:411:100:066:279)]][SK04PB12008:04:0448:0204132233:591:"
                  "1[(0105130000:471:084:037:279)(0105130911:105:037:027:277)(0105131225:227:027:011:260)(0105131748:295:0"
                  "11:000:276)]][SK05PB12008:04:0048:0204131719:458:0[(0105130000:172:051:034:277)(0105130437:282:034:010:"
                  "264)(0105131015:335:010:000:286)(0205130340:158:100:089:282)]][SK06LI19005:04:1414:0204131732:252:1[(01"
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
                  "56:070:038:287)(0105130655:301:038:014:277)(0105131308:477:014:000:264)(0205131003:266:100:081:283)]][SK"
                  "79PB12008:04:0030:0104132310:673:0[(0105130000:317:071:042:265)(0105130623:154:042:030:262)(0105131004:3"
                  "93:030:000:262)(0205130443:384:100:062:271)]][SK80LI19005:04:0580:0204131222:420:0[(0105130000:090:072:0"
                  "63:286)(0105130227:152:063:051:259)(0105130550:143:051:037:261)(0105131008:245:037:018:277)]]");
void setup() {  
  lcd.begin(16,2);
  digitalWrite(13, LOW);
  lcd.print("    POWER ON");
  lcd.setCursor(0,1);
  lcd.print("   smartSOLAR   ");
  delay(4000);
  
  setUpModem();

  configureModem(IPaddress,port);
  
} 


void loop() { 
  String stringToSend = "";
  int startIndex = 0;
  boolean allSent = false;
  int bytesToSend = fullString.length();
  
  int packetsToSend = (bytesToSend / 300) + 1;
  
  connectToServer();
  lcd.clear();
  lcd.print("Data: " + String(packetsToSend) + " packets.");
  delay(1000);
  
  int currentPacket = 1;
  while(!allSent){//Can only sent 1000 characters at a time
     lcd.clear();
      lcd.print("Packet " + String(currentPacket) + " of " + String(packetsToSend) + ".");
  
     if(startIndex < (bytesToSend - 300)){ //If start index is less than 990 bytes from the end of string
       char extract[301];
         fullString.copy(extract,300,startIndex);
         stringToSend = extract + '\0';
         sendData(stringToSend);
         startIndex +=300;
     }else{
         int stillToSend = bytesToSend - startIndex+1;
         stillToSend = stillToSend;
         Serial.println(stillToSend);
         char extract[stillToSend+1];
        fullString.copy(extract, stillToSend, startIndex);
        stringToSend = extract + '\0';
        Serial.println(stringToSend);
        stringToSend = stringToSend + ";";
        sendData(stringToSend);
        allSent = true;
     } 
     currentPacket++;
  }
  
  String receivedData = receiveData();
  

  closeSocket();


  Serial.println("Received data:\n "+ receivedData);
  lcd.clear();
  lcd.print("Received SOH &  "); 
  lcd.setCursor(0,1);
  lcd.print("disabled status");
  delay(10000);
  
  lcd.clear();
  lcd.print("Waiting 60 secs.");
  Serial.println("Waiting 60 seconds...\n");
  delay(60000);
}

//Waits for +SIND: 4 to be returned, meaning modem is ready
void setUpModem(){
  lcd.clear();
  lcd.print("Modem set up...");

  lcd.setCursor(0,1);
  //Initalise serial ports for communication
  Serial.begin(9600); //Computer comms
  Serial1.begin(115200);//modem
  Serial.print("Starting SM5100B Communication...");
  lcd.print("Starting SM5100B");
  pinMode(13,OUTPUT);
  delay(3000);

  boolean registered = false;
  while(!registered){             //Loop until correct message returned
    receivedString = receiveFromModem(); //Receive message from modem
    if(receivedString.equals("+SIND: 11")){ //SIND 11 is the message that the SIM is registered with network
      lcd.setCursor(0,1);
      lcd.print("Registered on TM");
      Serial.println("\nModem is registered on network and ready to communicate.");
      registered = true;          //break out of loop
    }else{
      lcd.setCursor(0,1);
      lcd.print("No signal...    ");
      Serial.println("No network found.");
      delay(500);
    }
  }
  delay(2000);
  
  boolean gprs = false;
  while(!gprs){             //Loop until correct message returned
    Serial1.println("AT+CGATT?");
    receivedString = receiveFromModem(); //Receive message from modem
    Serial.print(receivedString);
    Serial.print('.');       //Show that something is happening each time message comes through
    if(receivedString.equals("+CGATT: 1")){ //message that the GPRS is available
      lcd.setCursor(0,1);
      lcd.print("GPRS available  ");
      Serial.println("\nGPRS found on network.");
      gprs = true;          //break out of loop
    }else{
      lcd.setCursor(0,1);
      lcd.print("No GPRS found   ");
      Serial.println("\nNo GPRS found on network.");
      delay(500);
    }
  }
  delay(2000);
  Serial.println("Ready for configuration...");
  lcd.clear();
  lcd.print("Configuring...");
  delay(1000);
}

//Configures modem with specified IP and port for remote server
//TODO include APN settings as parameters here.
void configureModem(String IPaddress, String port){
  int successfulCommands = 0; //This int is incremented each time a successful command goes through to stop
  //later commands being carried out after failed command

  do{
    //Set up PDP context
    Serial1.println("AT+CGDCONT=1,\"IP\",\"general.t-mobile.uk\"");
    delay(2000);
    receivedString = receiveFromModem(); //Receive message from modem
    if(receivedString.equals("OK")){ //OK is expected
      lcd.setCursor(0,1);
      lcd.print("PDP context set ");
      Serial.println("\n\tPDP context set up successfully.");
      successfulCommands++; //increment, therefore breaking out of loop.
    }
    else{
      Serial.println("Something went wrong, retrying");
    }
  }
  while(successfulCommands == 0);

  do{
    //Set up PDP context parameters (APN username/password)
    Serial1.println("AT+CGPCO=0,\"tmobile\",\"tm\",1");
    delay(2000);
    receivedString = receiveFromModem(); //Receive message from modem
    if(receivedString.equals("OK")){ //OK is expected
      Serial.println("\tPDP context parameters set up successfully.");
      lcd.setCursor(0,1);
      lcd.print("PDP params set  ");
      successfulCommands++; //increment, therefore breaking out of loop.
    }
  }
  while(successfulCommands <= 1);

  do{
    //Activate PDP context
    Serial1.println("AT+CGACT=1,1");
    delay(2000);
    receivedString = receiveFromModem(); //Receive message from modem
    //    Serial.println(receivedString);
    if(receivedString.equals("OK")){ //OK is expected
      Serial.println("\tPDP context activated.");
      lcd.setCursor(0,1);
      lcd.print("PDP cont. active");
      successfulCommands++; //increment, therefore breaking out of loop.
    }
  }
  while(successfulCommands <= 2);

  do{
    //Configure remote host and port, then a TCP connection can be opened
    String remoteConfiguration = "AT+SDATACONF=1, \"TCP\", \"";
    remoteConfiguration += IPaddress;
    remoteConfiguration += "\", ";
    remoteConfiguration += port;
    Serial1.println(remoteConfiguration);
    delay(2000);
    receivedString = receiveFromModem(); //Receive message from modem
    if(receivedString.equals("OK")){ //OK is expected
      Serial.println("\tTCP parameters for connection to remote server configured.");
      lcd.setCursor(0,1);
      lcd.print("TCP params set  ");
      successfulCommands++; //increment, therefore breaking out of loop.
    }
  }
  while(successfulCommands <= 3);
  
   do{
    //Configure remote host and port, then a TCP connection can be opened
    Serial1.println("AT+SDATARXMD=1,1");
    delay(2000);
    receivedString = receiveFromModem(); //Receive message from modem
    if(receivedString.equals("OK")){ //OK is expected
      Serial.println("\tReceive mode set to string rather than hex.");
      lcd.setCursor(0,1);
      lcd.print("RXMD String set ");
      successfulCommands++; //increment, therefore breaking out of loop.
    }
  }
  while(successfulCommands <= 4);

  delay(2000);

  Serial.println("\nSet up complete, ready to send over GPRS/GSM.");
  lcd.setCursor(0,1);
  lcd.print("complete.       ");
  delay(2000);
}

void connectToServer(){
  lcd.clear();
  lcd.print("Connecting serv.");

  int successfulConnect = 0;
  do{
    //Open connection
    Serial1.println("AT+SDATASTART=1,1");
    delay(2000);
    receivedString = receiveFromModem(); //Receive message from modem
    if(receivedString.equals("OK")){ //OK is expected
      Serial.println("\n\tAttempted to open socket.");
      lcd.setCursor(0,1);
      lcd.print("Opening socket  ");
      boolean querySuccess = false;
      do{
        //Check that socket is connected
        Serial1.println("AT+SDATASTATUS=1");
        delay(2000);
        receivedString = receiveFromModem(); //Receive message from modem
        String trimmedString = receivedString.substring(0,11);
        if(trimmedString.equals("+SOCKSTATUS")){ //This is the start of the returned message
          if(receivedString[16] == '1'){ //+SOCKSTATUS:  1,0,0000,0,0,0 this is the returned message
            querySuccess=true;            //16th character is 0 for not connected, 1 for connected
            successfulConnect++; //increment, therefore breaking out of main loop.
            Serial.println("\tConnected to remote server.");
            lcd.setCursor(0,1);
            lcd.print("Connected server");
            digitalWrite(13, HIGH);
            delay(2000);
          }
          else{
            Serial.println("\tUnsuccessful connection, trying again...");
            querySuccess= true;
            lcd.setCursor(0,1);
            lcd.print("Trying again... ");
            //no index increment

              //Send close socket command to ensure that modem has closed socket
            //before trying again.
            boolean successfulCommand=false;
            do{
              Serial1.println("AT+SDATASTART=1,0");
              delay(2000);
              receivedString = receiveFromModem(); //Receive message from modem
              if(receivedString.equals("OK")){ //OK is expected
                successfulCommand=true;
              }
            }
            while(!successfulCommand);
          }
        }
      }
      while(!querySuccess);
    }
  }
  while(successfulConnect == 0); 
  
}

//Called when data is required to be sent to remote server
void sendData(String sendString){
  int successfulSend = 0;
  
  //Send some data
  Serial.println("\tSending data...");
  lcd.setCursor(0,1);
  lcd.print("Sending...      ");
  delay(1000);
  String stringToSend = "AT+SSTRSEND=1, \"";
  stringToSend += sendString;
  stringToSend += "\"";
  Serial1.println(stringToSend);

  do{
    receivedString = receiveFromModem(); //Receive message from modem
    if(receivedString.equals("OK")){ //This is the start of the returned message
      Serial.println("\tData sent.");
      lcd.setCursor(0,1);
      lcd.print("Data sent.       ");
      delay(1000);
      successfulSend++; //increment, therefore breaking out of loop.      
    }
    else{
      Serial.println("\tStill waiting for data to send...");
      lcd.setCursor(0,1);
      lcd.print("Still sending...");
      delay(500);
    }
  }
  while(successfulSend == 0);
}

//Returns string received from the server
String receiveData(){
  lcd.clear();
  lcd.print("Waiting for RX  ");
  Serial.println("\n\tWaiting to receive data from remote server...");
  String message = "";
  
  int currentPacket = 1;
    do{ //Data is sent as packets of 50 bytes, final one terminated with a ';' so loop until this is found.
    boolean receivedData = false;
    while(!receivedData){
      String modemStatus = receiveFromModem();
      if(modemStatus.equals("+STCPD:1")){  //this message indicates data received from server
        Serial.println("\tData available from modem.");
        receivedData = true;
        lcd.setCursor(0,0);
        lcd.print("Receiving...    ");
      }
    }

     Serial1.println("AT+SDATAREAD=1");
     delay(1000);
     receivedString = receiveFromModem(); 
     lcd.setCursor(0,1);
     lcd.print("Packet " + String(currentPacket) + " read.");
     Serial.println("\tData read from modem.");
     message += receivedString.substring(8); //From index 9 to the end of the string
     currentPacket++;
   }while(message[message.length()-1] != ';');
  
  return message;
}

void closeSocket(){
      boolean successfulClose = false;
     //Close the socket
  do{
    Serial1.println("AT+SDATASTART=1,0");
    receivedString = receiveFromModem(); //Receive message from modem
    if(receivedString.equals("OK")){ //OK is expected
      Serial.println("\tSocket closed.\n");
      lcd.setCursor(0,1);
      lcd.print("Socket closed.  ");
      digitalWrite(13, LOW);
      successfulClose = true;
      delay(2000);
    }
  }
  while(!successfulClose);  
}

//Should be run when message is expected from modem
//Returns the message from modem that can be compared.
String receiveFromModem(){ 
  String inString="";
  char incoming = 0;
  boolean receivedMessage = false;

  while(!receivedMessage){  //while no message found
    if(Serial1.available()>0){ //Look for serial data
      incoming = Serial1.read(); //read one byte from buffer    
      if(incoming == '\n'){ //if the byte is the new line character (indicates end of modem message)
        inString.trim();   //Remove unnecessary white space (causes issues with.equals)
        if(inString.length()>0){
          return inString;  //return the string
        }
        else{
          inString = "";
        }
      }
      inString += incoming;  //else add to the message and look for another byte
    } 
  }
}
