chakkums/smart-solar/(commit log)

2013-04-07 Modem Control
    Testing using arduino to control modem, this uses an Uno to send the
    current time in millis to the server, which then displays.
2013-04-07 Time Server
    Receives time from remote system (v1.1 Modem Control Arduino) and
    updates database. DATABASE MUST BE MADE PROIR TO RUNNING
2013-04-07 Android
    Initial Android app to scan a battery's code and get information from
    server.
2013-04-16 Checking for GPRS availability
    Issues during demonstration proved that the modem could feasilbly
    connect to the network without having GPRS connection. System failed,
    maintenance included to improve the robustness, and check for GPRS
    connection.
    Fritzing diagrams of circuit included.
    [Prototype Circuit.fzz]
2013-04-16 Added Splashscreen to mega code
    Also was waiting for wrong status code for registered on network.
    [MegaModemControl_v2_0.ino]
2013-04-18 Final Report, Schematics and Pictures
    Final submission including report etc.
    [Prototype Circuit.fzz]
